martin-ger/ESP8266-WiFi-Socket/(commit log)

2018-02-22 added wifidisconnect, led off
2018-02-22 added Arduino script
2018-03-29 Found ADC
2018-03-30 Update OBISocket.ino
    Added power measurement in sketch
2018-03-31 description of power measurement
2018-03-31 circuit diagram
